SP5GW/Acoustic_Amplifier_For_SDR_Receiver/README.md

                                                                                                      
**<p style="text-align: center;">Acoustic Amplifier for SDR Receiver</p>**
<p style="text-align: center;">Rev. B, August 2023, Andrzej SP5GW</p>
<p align="center">
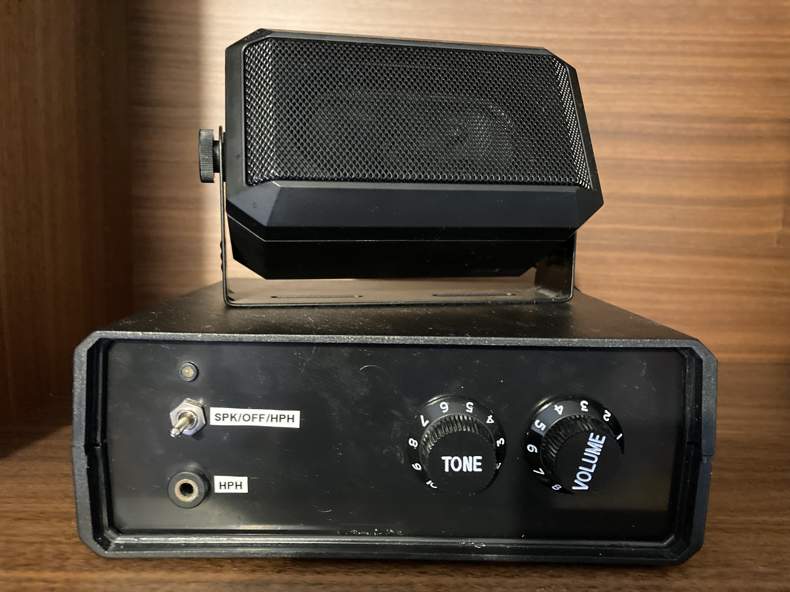
[picture p1: img/amp_front.jpg]


</p>

**Key Requirements**

The main requirements for this amplifier are the following:

* It shall be possible to connect it to the output of sound card of the PC or Raspberry Pi.The output volume of the sound card shall be set to approximately 80% of maximum value.
* The amplifier shall be monophonic, but it shall accept stereo input signal.
* It shall be possible to control, both volume and tone using same knobs for headphone and speaker channels.
* It shall be possible to control tone of voice starting from about 2.5kHz (the assumption is that SSB emission is limited in bandwidth to about 3kHz).
* Amplifier bandwith shall be not less then 100Hz - 10kHz.
* It shall be possible to use USB socket of the PC as power source, but option to connect other power supply shall exist (9-12V DC input).
* It shall be possible to switch between headphones and speaker with toggle switch, which also acts as on/off switch.
* Use of headphones or speaker shall be indicated by LED.
* All audio sockets shall be 3.5mm mini jack type.
* USB port shall be micro USB type.

**Architecture**

Amplifiers design is based on:

* AVT 1744 (10W Power Amplifier  based on TDA2003),
* AVT 794 (Power Amplifier with LM386)

Toggle switch SW1 selects, which one of two power amplifiers is powered on at given moment making it possible to select between speaker and headphone operations.

CB BV-550 8ohm 5W spkeaker  from Blow is used together with Sony MDR-V150 standard computer headphone speakers. Spkear and headphone makes are not critical.

The following componets outside AVT kits were also added:

* Automatic power source selector based on Shotkey diodes D2 and D3 (source supplying higher voltage is selected).
* EMC filter based on L1 and C8, C9 and C10
* Stereo to mono signal mixer based on resistors R1 and R2
* Volume and Tone control including signal divider based on  RV1, RV2, C1, R3 and R4
* Bi-color LED is used in actual design instead of LED D1 and D4

Attempt was made to skip dedicated amplifier in headphone channel, but then it was not possible to find well working passive volume/tone control, which would control both speaker and headphones. This was a reason for adding AVT 794 to the design.

Input voltage divider (R3 and R4) is designed to lower the maximum volume of the device to comfortable level and at the same time make speaker and headphone channel volume levels comparable for the same setting of volume knob RV1. In practice this means that headphone channel acts as power attenuator (approx. 40% attenuation) while speaker channel amplifies input signal from PC's sound card by approx. 2.6 times (see measurement section for more details).

When USB is used as a DC power source then in order to avoid distortions of output signal (see Fig. 3) the level of input signal provided by the sound card shall be reduced to the amplitude not exceeding 680mV. 

To avoid EMC interference shielded or twisted cables where used to interconnect all the modules. Positioning of the PCB boards have been also optimized with EMC in mind.

Especially EMC prone components such as tone control RV2 were grounded (chassis). Interconnect cable between RVmax and RVslider on AVT 794 was twisted with ground wire for the same purpose.    

Amplifier's circuit diagram can be seen below:
<p align="center">
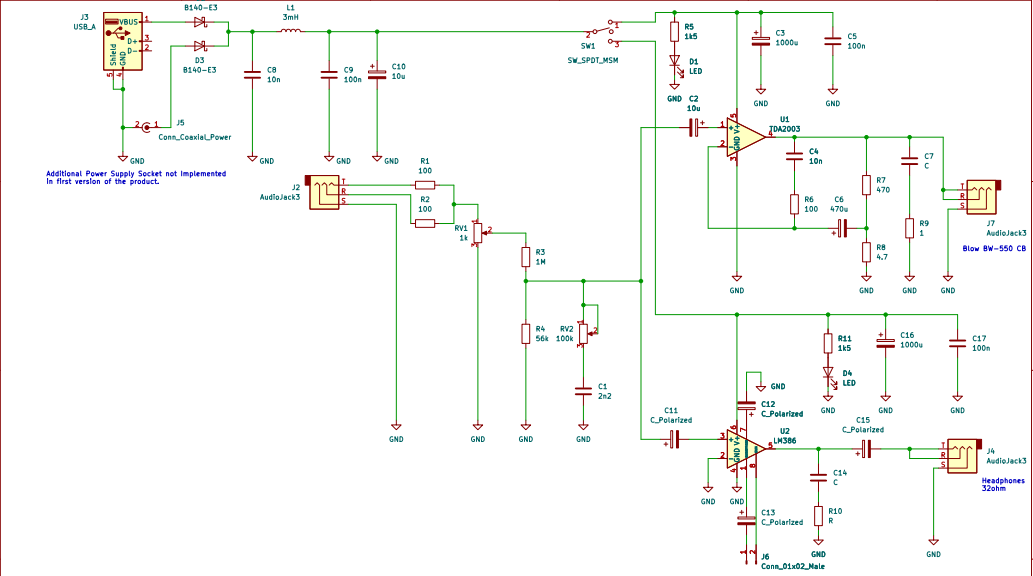
[picture p3: docs/CircuitDiagram.png]
	
</p>

**Characteristics Measurements**

Speaker channel amplification based on measurements for scenario 4 (input signal 1kHz, Vcc=5V (amplifier powered from USB port) and Uin=0.68V): G=Uout/Uin = 1.37V/0.68V = 2 (see picture below). 
<p align="center">
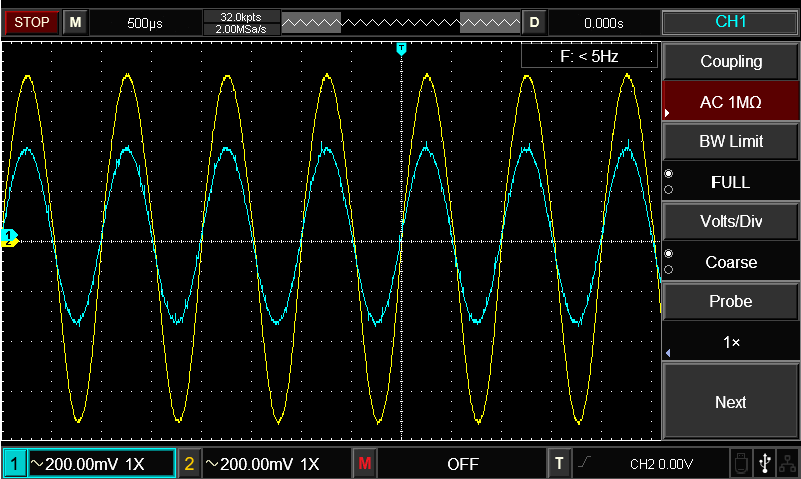
[picture p4: measurements/Scenario4/SpeakerChannelAmplificationAdjLevel.png]
	
</p>
Headphone channel attenuates sound card signal. Based measurements done in test scenario 5 (input signal 1kHz, Vcc= 5V) attenuation value is: G=Uout/Uin = 0.4V/0.67V = 0.6 (40% attenuation). 
Change from speaker to headphones does not cause the change in perceived sound level (assuming volume knob is not adjusted).
<p align="center">
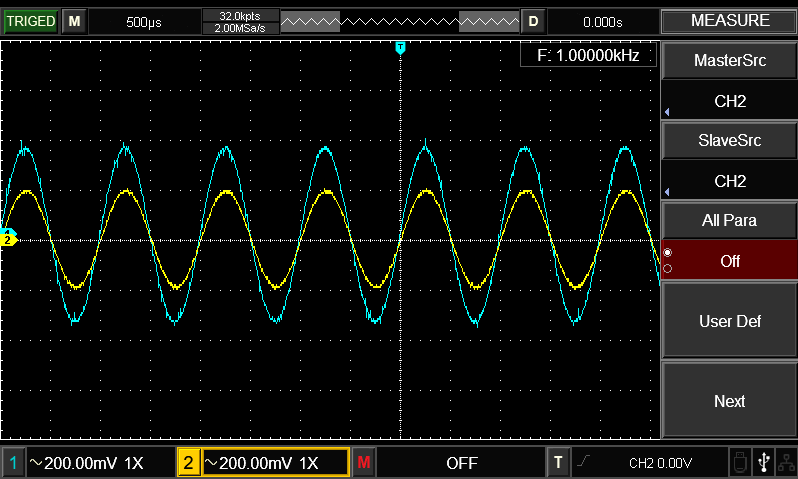
[picture p5: measurements/Scenario5/HeadphoneChannelAmplification.png]
	
</p>

When Vcc is increased to 12V Uin can be increased to 1.5V  without distortions present in output signal Uout for speaker channel (scenario 1), corresponding  gain for this scenario increases to G=3.76V/1.5V = 2.5.
Please note however that when Vcc is switched to 5V (USB port) while Uin is kept on 1.5V then level of Uout distortions is unacceptable - scenario 3 (see picture below).
<p align="center">
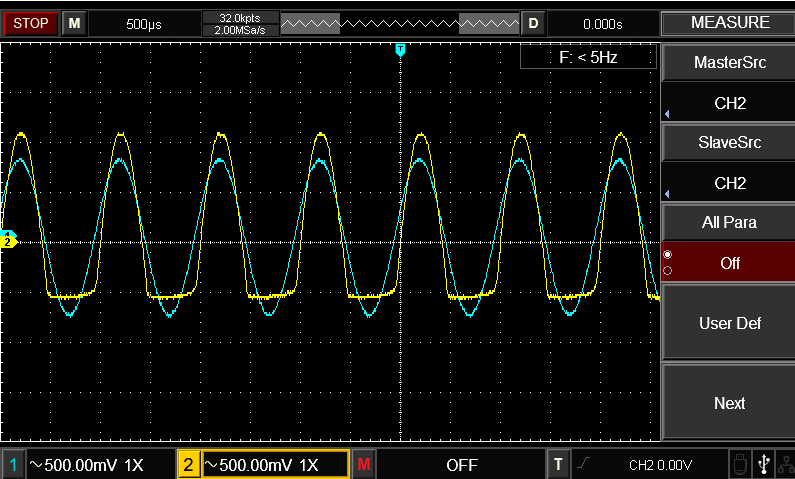
[picture p6: measurements/Scenario3/SpeakerChannelDistortedOutput.png]
	
</p>

Based on measurements conducted as part of measurement scenario 2, -3dB bandwidth for speaker channel is 25Hz - 10.6kHz. No such measuremets were conducted for headphone channel. 

**Simulations**

* Simulation results of EMC filter
LTSpice simulation of EMC filter has been conducted to mainly find out minimum value of inductor used. Results are depicted below:
<p align="center">
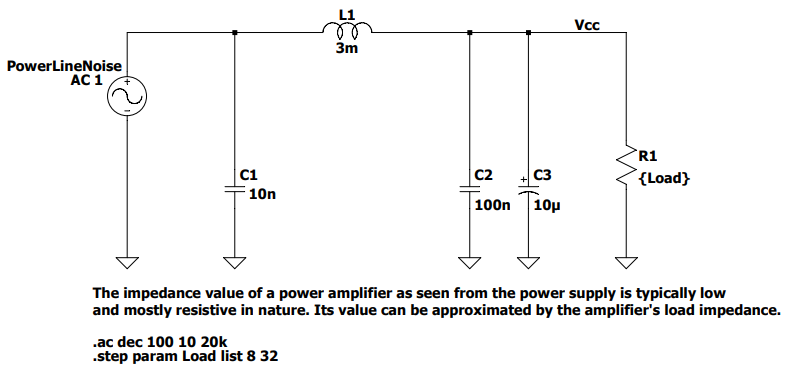
[picture p7: ltspice/EMCFilterSimulationCircuit.png]
	
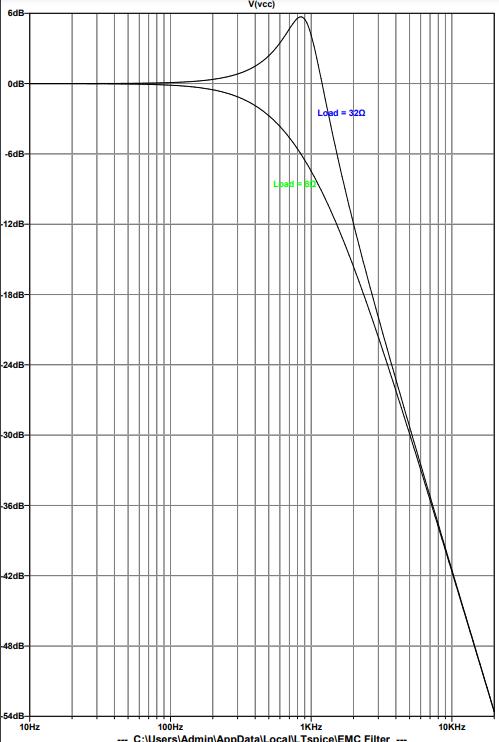
[picture p8: ltspice/EMCFilterSimulationResult.png]
	
</p>

* Simulation result of Tone control circuit
Simulation of tone control circuit suggests that better results (less attenuation of frequencies above 1kHz in potentiometer position when tone control shall have minimum impact) can be achieved when using 1Meg potentiometer. This is potential future improvement.
<p align="center">
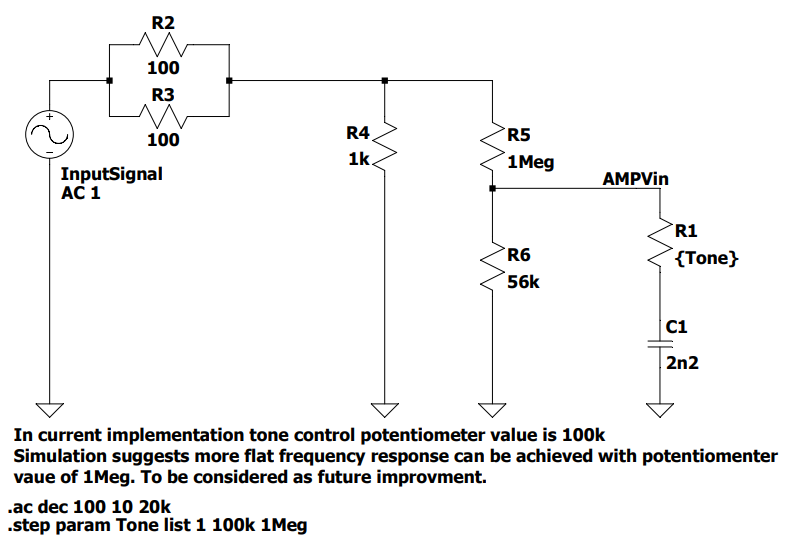
[picture p9: ltspice/ToneControlSimulationCircuit.png]
	
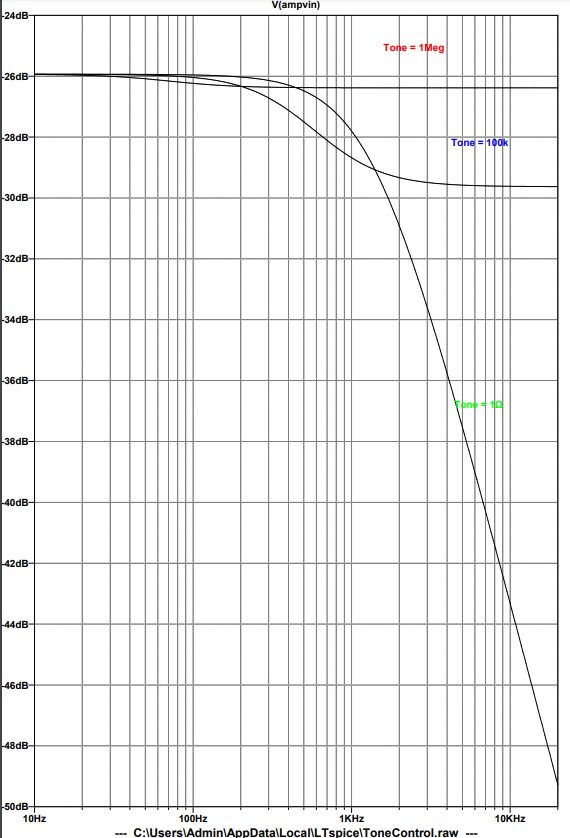
[picture p10: ltspice/ToneControlSimulationResult.png]
	
</p>

**References**

* <a href= "https://sklep.avt.pl/pl/products/wzmacniacz-mocy-10w-z-tda2003-kit-avt1744-167281.html?query_id=2">AVT 1744 </a>
* <a href="https://sklep.avt.pl/pl/products/wzmacniacz-akustyczny-z-ukladem-lm386-kit-avt794-172112.html?query_id=3">AVT 794</a>  
* <a href="https://www.ftdichip.com/Support/Documents/AppNotes/AN_146_USB_Hardware_Design_Guidelines_for_FTDI_ICs.pdf">USB Hardware Design Guidelines</a>
