SP5GW/Acoustic_Amplifier_For_SDR_Receiver/ltspice/EMCFilter_Simulation_Circuit.pdf

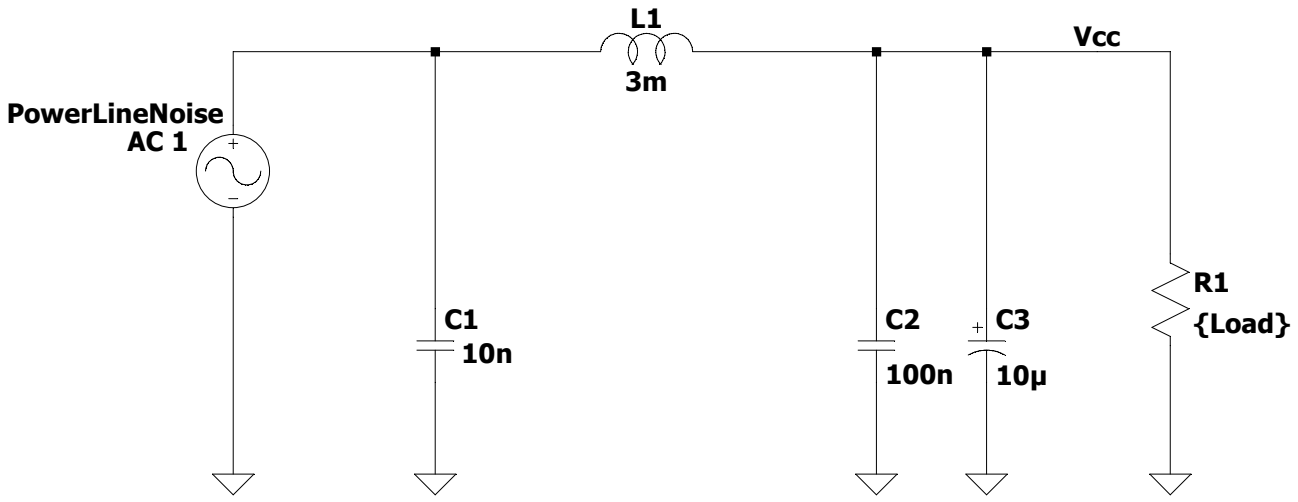
[picture p11: figure]
PowerLineNoise; R1 {Load}; Vcc

.ac dec 100 10 20k
.step param Load list 8 32

The impedance value of a power amplifier as seen from the power supply is typically low
and mostly resistive in nature. Its value can be approximated by the amplifier's load impedance.

--- C:\Users\Admin\AppData\Local\LTspice\EMC Filter.asc ---
