SP5GW/Acoustic_Amplifier_For_SDR_Receiver/ltspice/ToneControl_Simulation_Circuit.pdf

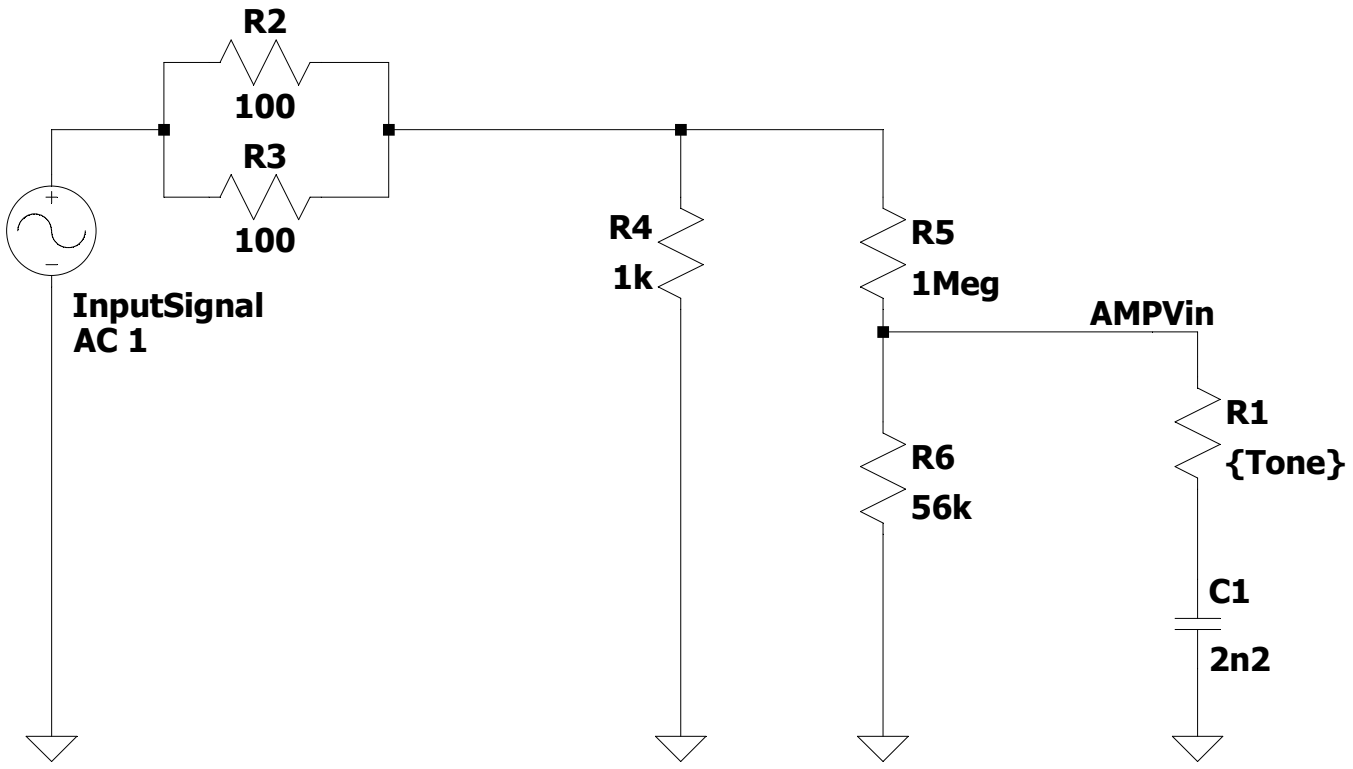
[picture p12: figure]
InputSignal; R1 {Tone}; R5 1Meg; AMPVin

.ac dec 100 10 20k
.step param Tone list 1 100k 1Meg

In current implementation tone control potentiometer value is 100k
Simulation suggests more flat frequency response can be achieved with potentiomenter vaue of 1Meg. To be considered as future improvment.

--- C:\Users\Admin\AppData\Local\LTspice\ToneControl.asc ---
