SP5GW/Acoustic_Amplifier_For_SDR_Receiver/img/amp_back.jpg

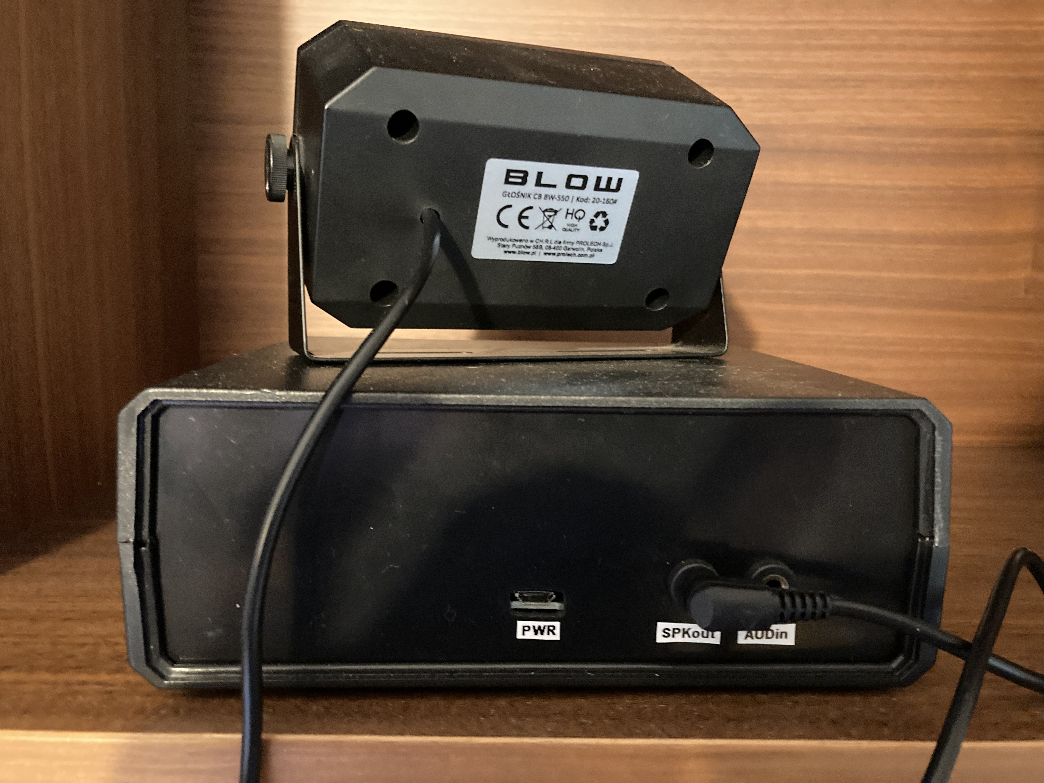
img/amp_back.jpg
