SP5GW/Acoustic_Amplifier_For_SDR_Receiver/img/amp_internal_view_2.jpg

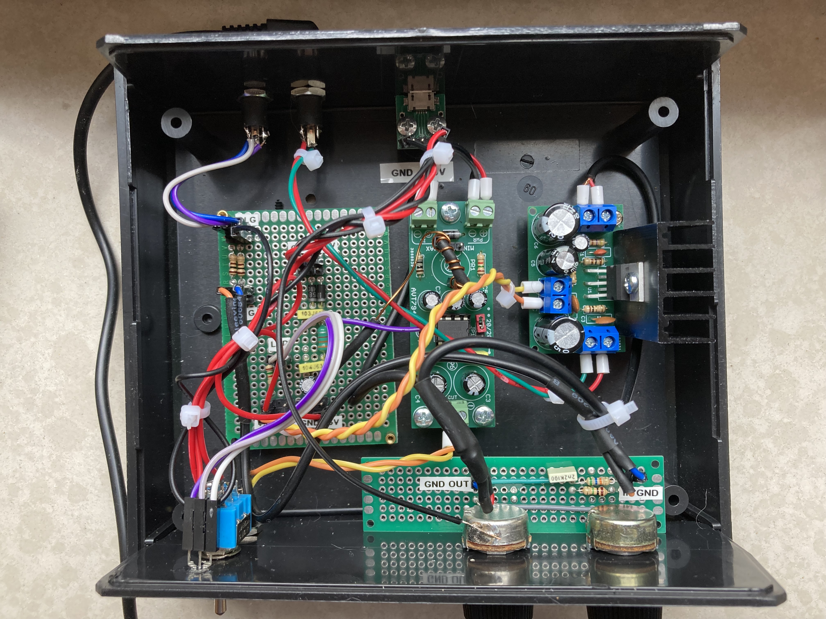
img/amp_internal_view_2.jpg
