SP5GW/Acoustic_Amplifier_For_SDR_Receiver/img/amp_internal_view_3.jpg

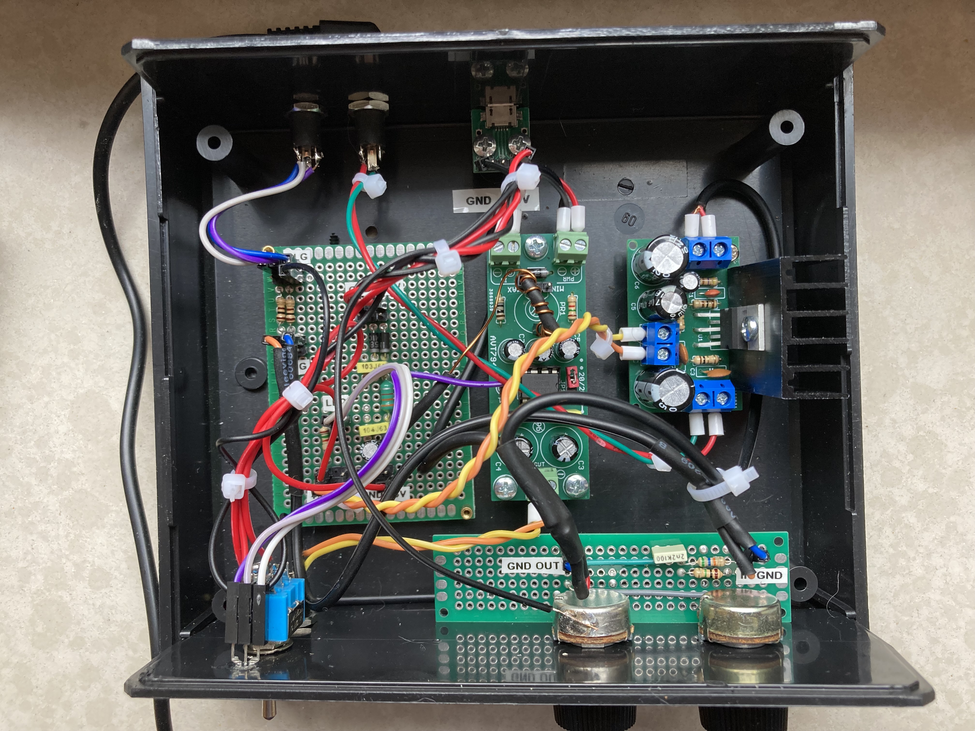
img/amp_internal_view_3.jpg
