SP5GW/Acoustic_Amplifier_For_SDR_Receiver/ltspice/EMCFilter_Simulation_Result.pdf

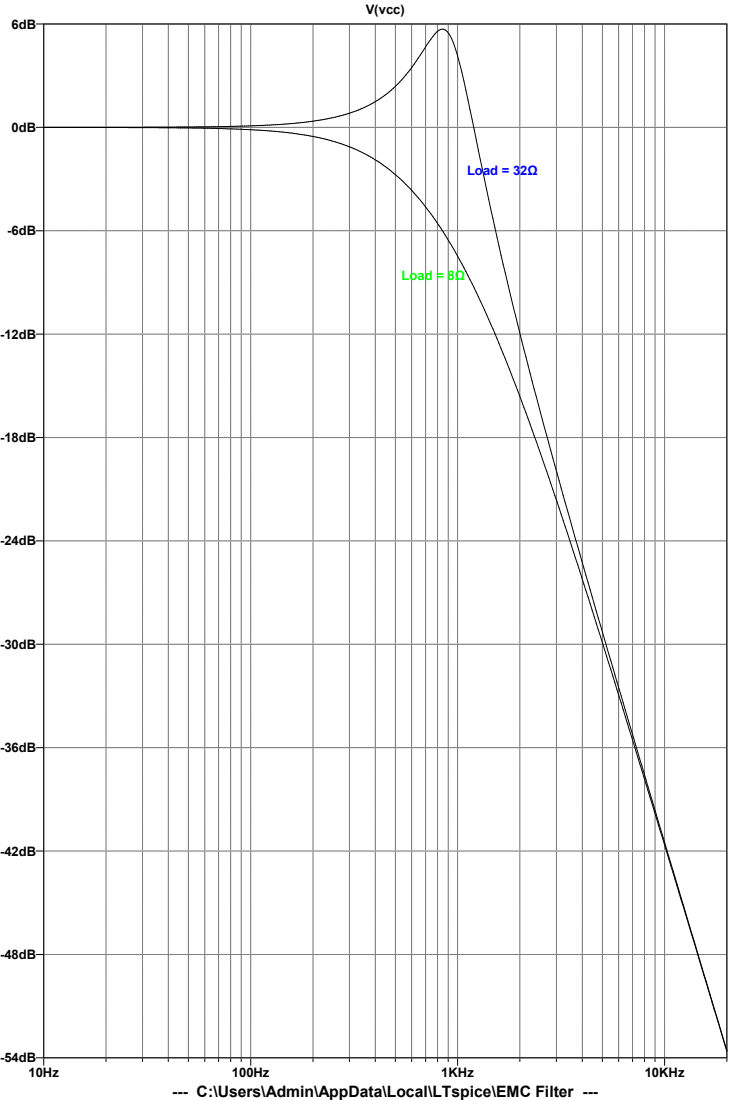
[picture p16: page 1]
1KHz; 10KHz; V(vcc); Load = 8Ω; Load = 32Ω

--- C:\Users\Admin\AppData\Local\LTspice\EMC Filter ---
