SP5GW/Acoustic_Amplifier_For_SDR_Receiver/docs/AcousticAmplifierForSDRReceiver_Rev_B.pdf

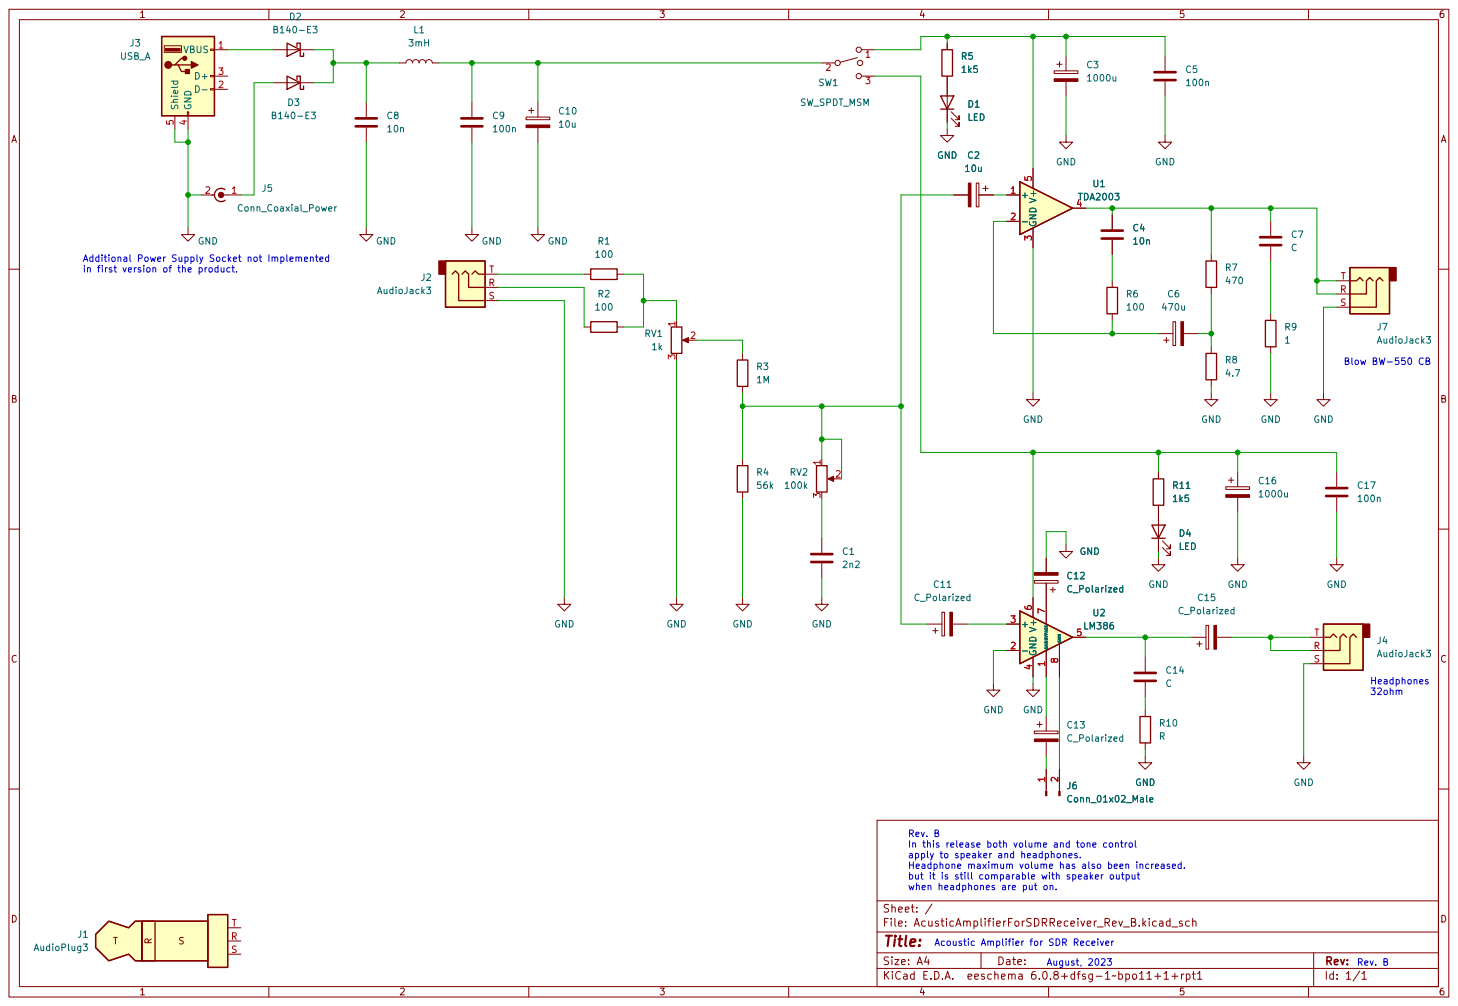
[picture p17: page 1]

Additional Power Supply Socket not Implemented
in first version of the product.

Acoustic Amplifier for SDR Receiver Rev. B
In this release both volume and tone control apply to speaker and headphones.

Headphone maximum volume has also been increased.
but it is still comparable with speaker output
when headphones are put on.
File: AcusticAmplifierForSDRReceiver_Rev_B.kicad_sch Sheet: /
Id: 1/1 Title:
