SP5GW/Acoustic_Amplifier_For_SDR_Receiver/ltspice/ToneControl_Simulation_Result.pdf

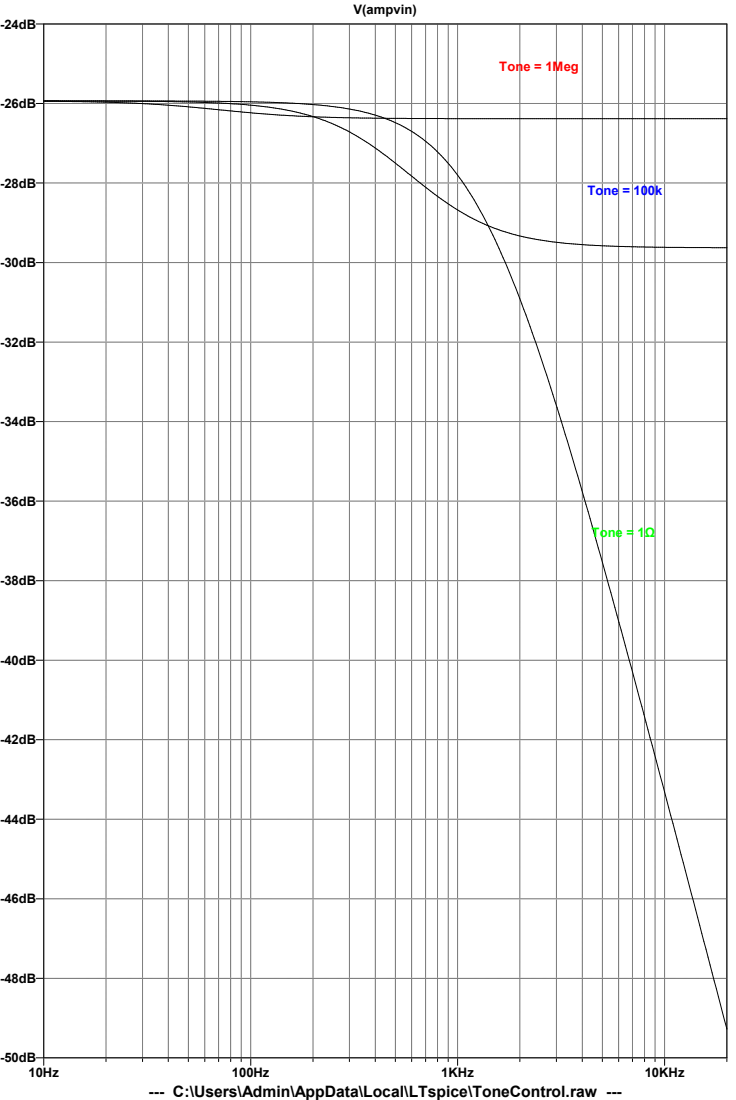
[picture p18: page 1]
1KHz; 10KHz; V(ampvin); Tone = 1Ω; Tone = 100k; Tone = 1Meg

--- C:\Users\Admin\AppData\Local\LTspice\ToneControl.raw ---
