SP5GW/Acoustic_Amplifier_For_SDR_Receiver/ltspice/EMCFilter LTSpice.asc

C1: cap; 10n
C2: cap; 100n
C3: polcap; 10µ
L1: ind; 3m
PowerLineNoise: signal; ""; AC 1
R1: res; {Load}
Named nets: 0, Vcc
.ac dec 100 10 20k
.step param Load list 8 32
The impedance value of a power amplifier as seen from the power supply is typically low
and mostly resistive in nature. Its value can be approximated by the amplifier's load impedance.
