SP5GW/Acoustic_Amplifier_For_SDR_Receiver/ltspice/ToneControl LTSpice.asc

C1: cap; 2n2
InputSignal: signal; ""; AC 1
R1: res; {Tone}
R2: res; 100
R3: res; 100
R4: res; 1k
R5: res; 1Meg
R6: res; 56k
Named nets: 0, AMPVin
.ac dec 100 10 20k
.step param Tone list 1 100k 1Meg
In current implementation tone control potentiometer value is 100k
Simulation suggests more flat frequency response can be achieved with potentiomenter
vaue of 1Meg. To be considered as future improvment.
