SP5GW/Acoustic_Amplifier_For_SDR_Receiver/measurements/Scenario1/DSO_2023-10-07 21-11-32_s1a.png

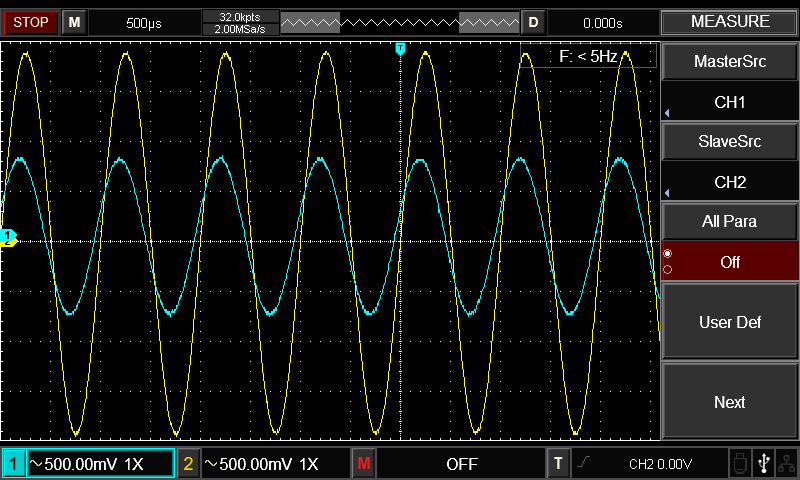
measurements/Scenario1/DSO_2023-10-07 21-11-32_s1a.png
