SP5GW/Acoustic_Amplifier_For_SDR_Receiver/measurements/Scenario2/DSO_2023-10-07 21-11-32_s2b.png

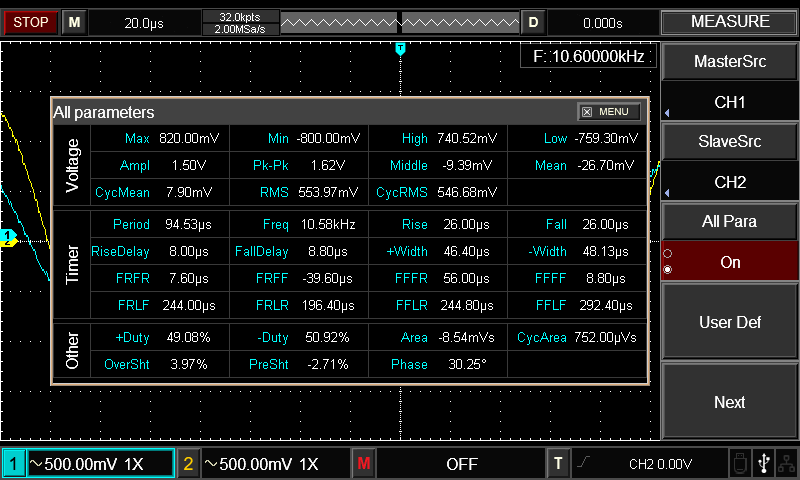
measurements/Scenario2/DSO_2023-10-07 21-11-32_s2b.png
