SP5GW/Acoustic_Amplifier_For_SDR_Receiver/img/amp_internal_view_1.jpg

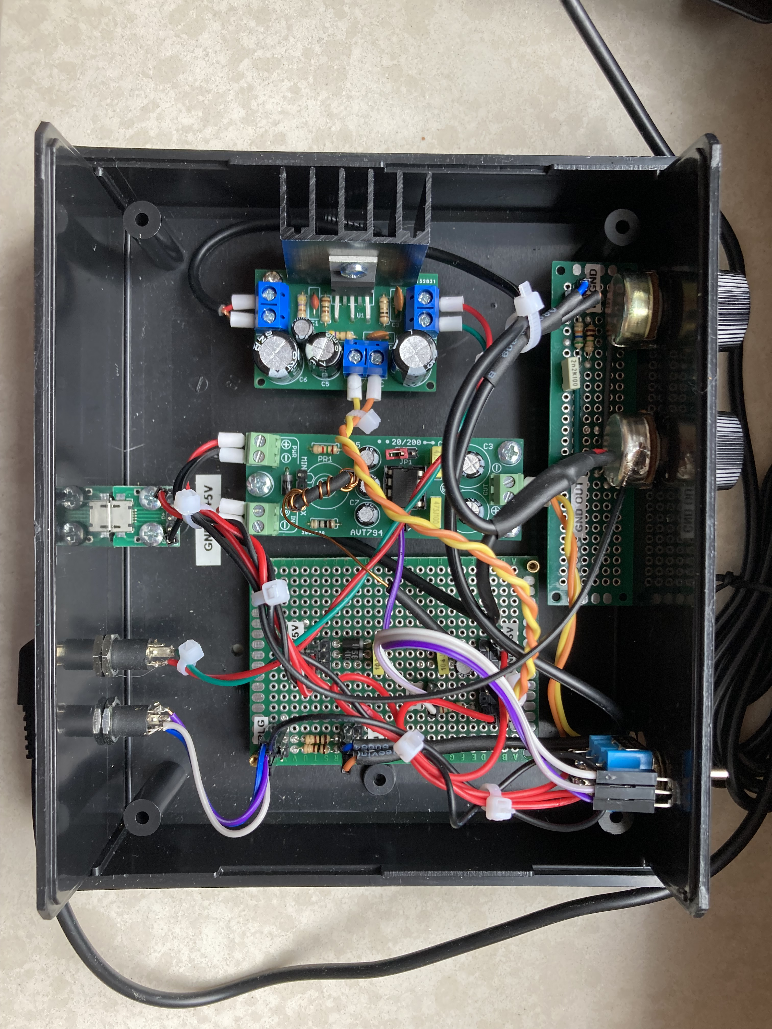
[picture p2: img/amp_internal_view_1.jpg]
img/amp_internal_view_1.jpg
